mhammaddiranyeng-cell/RiverExtract/figs/photo_crop.jpg

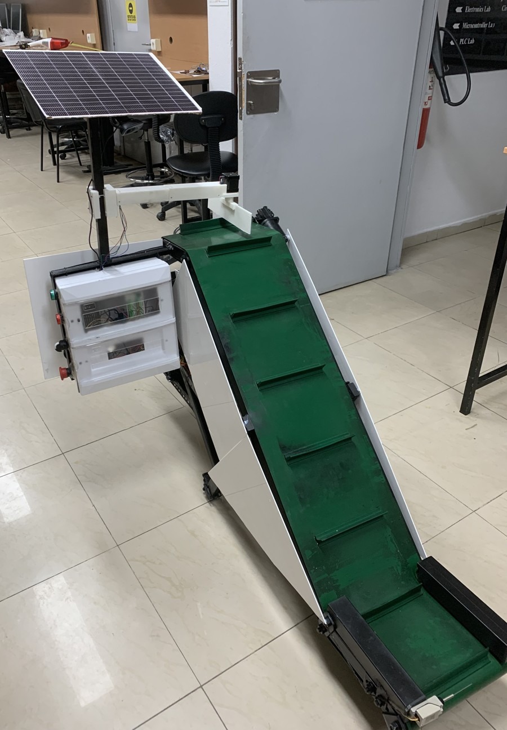
figs/photo_crop.jpg
