mhammaddiranyeng-cell/RiverExtract/figs/fig_geometry.pdf

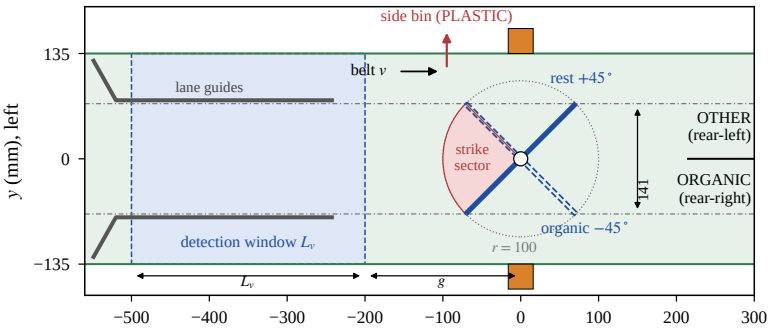
[picture p2: figure]
m), left; belt v lane guides; rest +45 ∘; side bin (PLASTIC)

### x (mm), downstream

| | OTHER (rear-left) strike sector ORGANIC (rear-right)
| detection window Lv | organic −45 ∘ r = 100

### (a) plan view at the design point

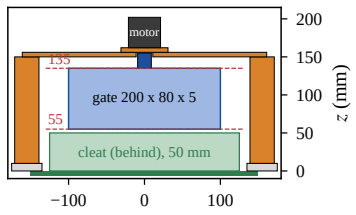
[picture p3: figure]
cleat (behind), 50 mm; motor; gate 200 x 80 x 5

### y (mm)

### (b) section through the pivot
