mhammaddiranyeng-cell/RiverExtract/figs/fig_maps.pdf

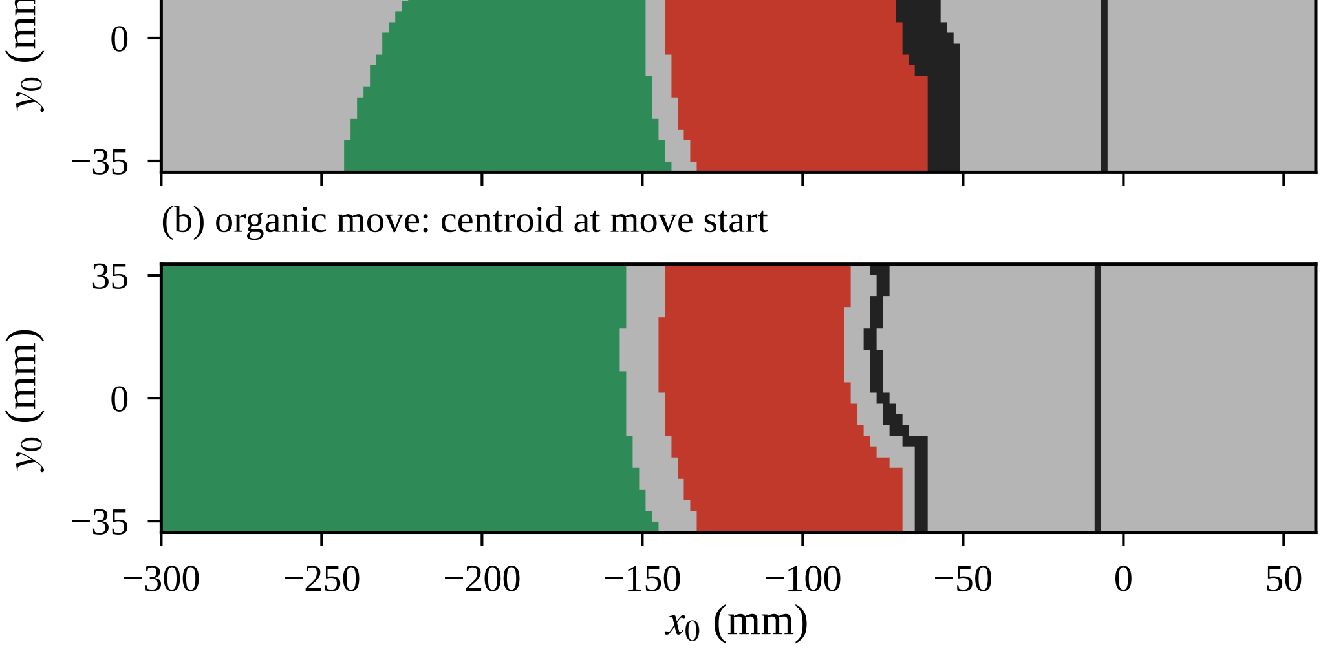
[picture p4: figure]

0

35

m)

(a) plastic strike: centroid at stroke start

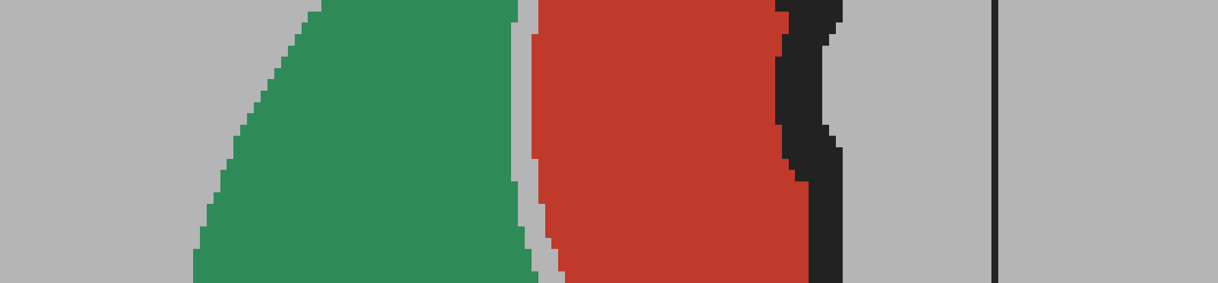
[picture p5: figure]

(b) organic move: centroid at move start

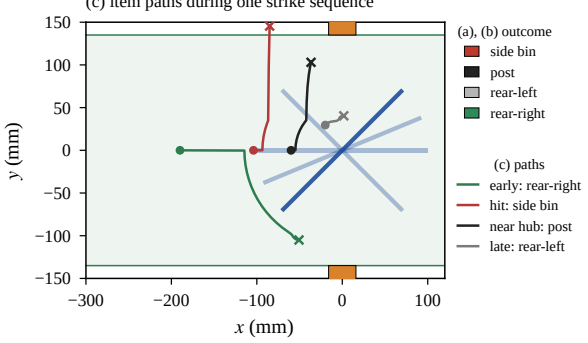
[picture p6: figure]
(c) paths early: rear-right hit: side bin near hub: post late: rear-left; (a), (b) outcome side bin post rear-left rear-right

(c) item paths during one strike sequence
