mhammaddiranyeng-cell/RiverExtract/figs/fig_motion.pdf

0

30

60

90

# Δθ (deg)

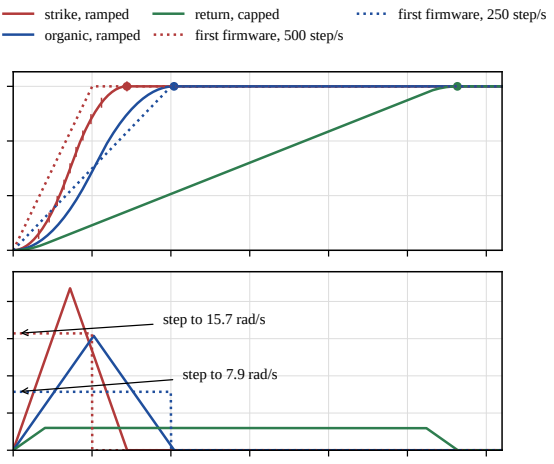
[picture p7: figure]
step to 15.7 rad/s; step to 7.9 rad/s; strike, ramped organic, ramped; return, capped first firmware, 500 step/s; first firmware, 250 step/s

0.0 | 0.1 | 0.2 | 0.3 | 0.4 | 0.5 | 0.6

## time (s)

0

5

10

15

20

## ω (rad/s)
