mhammaddiranyeng-cell/RiverExtract/cad/stl/RiverExtract_v2_SpacerR.stl

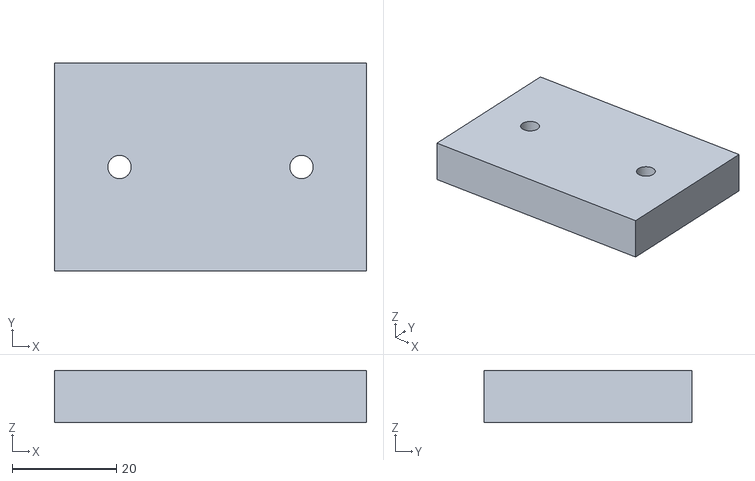
[picture p8: CAD file, 2026-11-01]
cad/stl/RiverExtract_v2_SpacerR.stl
60.0 x 40.0 x 10.0
