mhammaddiranyeng-cell/RiverExtract/cad/stl/RiverExtract_v2_ALL_bed_layout.stl

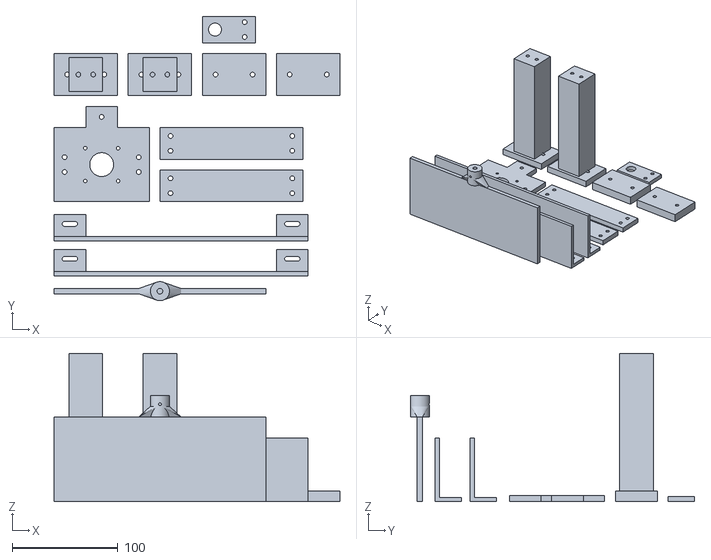
[picture p9: CAD file, 2026-11-01]
cad/stl/RiverExtract_v2_ALL_bed_layout.stl
270.0 x 268.5 x 140.0
