mhammaddiranyeng-cell/RiverExtract/cad/stl/RiverExtract_v2_PostR.stl

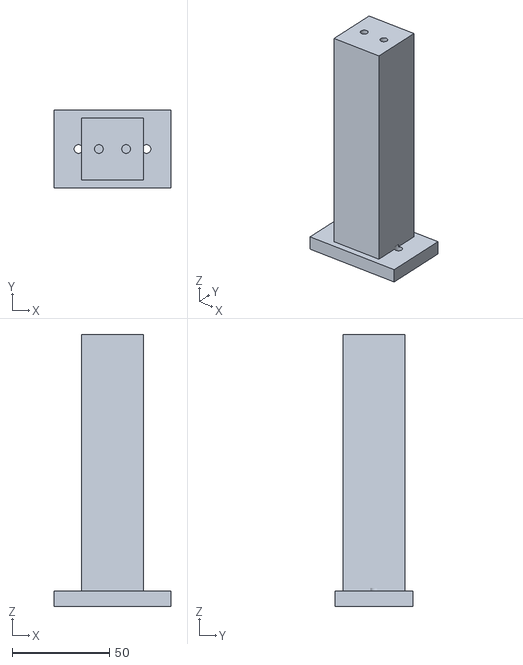
[picture p10: CAD file, 2026-11-01]
cad/stl/RiverExtract_v2_PostR.stl
60.0 x 40.0 x 140.0
