mhammaddiranyeng-cell/RiverExtract/cad/stl/RiverExtract_v2_Gate.stl

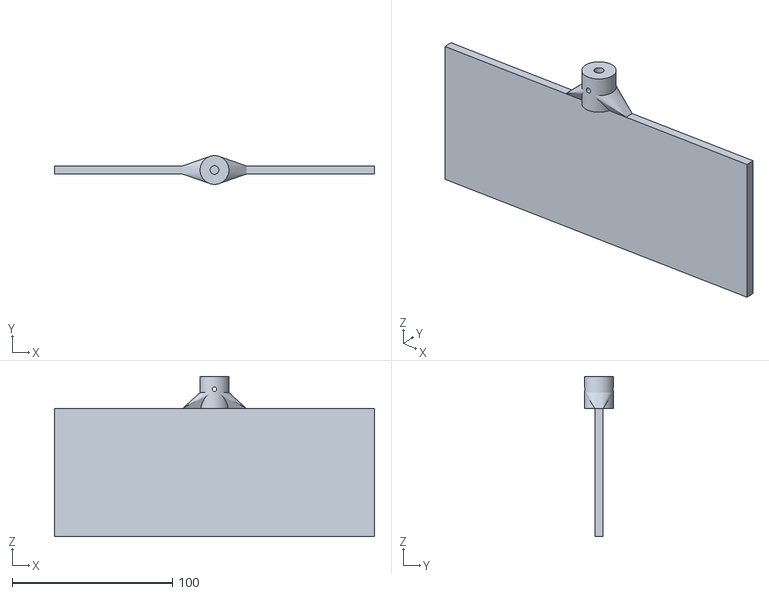
[picture p11: CAD file, 2026-11-01]
cad/stl/RiverExtract_v2_Gate.stl
200.0 x 18.0 x 100.0
