mhammaddiranyeng-cell/RiverExtract/cad/stl/RiverExtract_v2_BeamR.stl

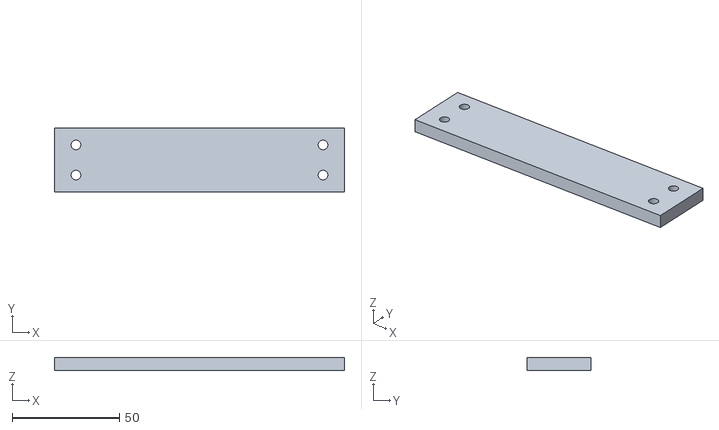
[picture p12: CAD file, 2026-11-01]
cad/stl/RiverExtract_v2_BeamR.stl
135.0 x 30.0 x 6.00
