mhammaddiranyeng-cell/RiverExtract/cad/stl/RiverExtract_v2_GuideR.stl

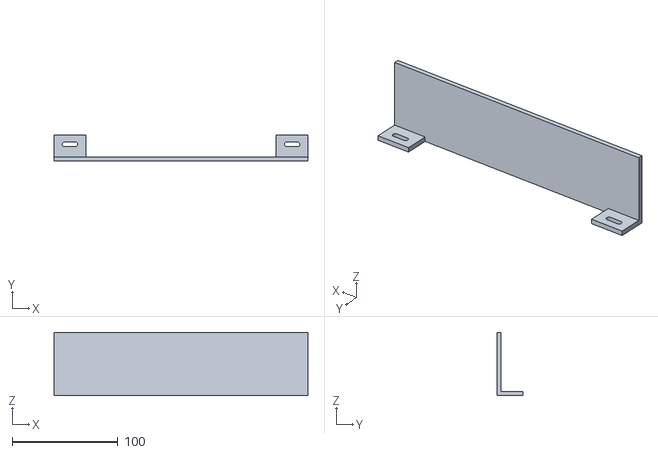
[picture p13: CAD file, 2026-11-01]
cad/stl/RiverExtract_v2_GuideR.stl
240.0 x 25.0 x 60.0
