mhammaddiranyeng-cell/RiverExtract/cad/stl/RiverExtract_v2_Center.stl

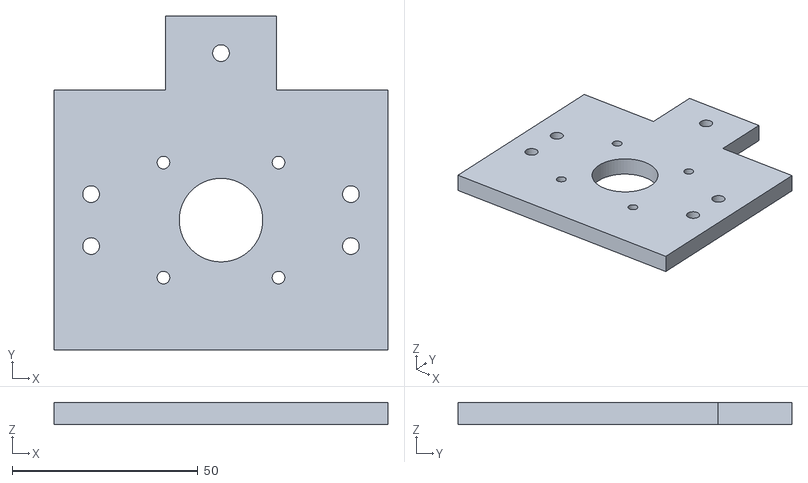
[picture p14: CAD file, 2026-11-01]
cad/stl/RiverExtract_v2_Center.stl
90.0 x 90.0 x 6.00
