mhammaddiranyeng-cell/RiverExtract/cad/stl/RiverExtract_v2_Sensor.stl

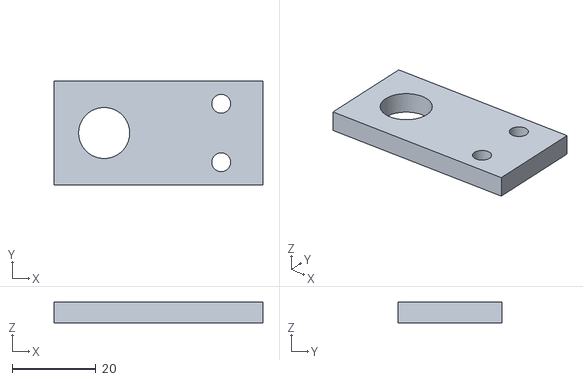
[picture p15: CAD file, 2026-11-01]
cad/stl/RiverExtract_v2_Sensor.stl
50.0 x 25.0 x 5.00
