mhammaddiranyeng-cell/RiverExtract/(list of files, cad)

Other CAD files:
cad/stl/RiverExtract_v2_SpacerL.stl
cad/stl/RiverExtract_v2_GuideL.stl
cad/stl/RiverExtract_v2_BeamL.stl
cad/stl/RiverExtract_v2_PostL.stl
