mhammaddiranyeng-cell/RiverExtract/figs/fig_overview.pdf

(a)

(b)

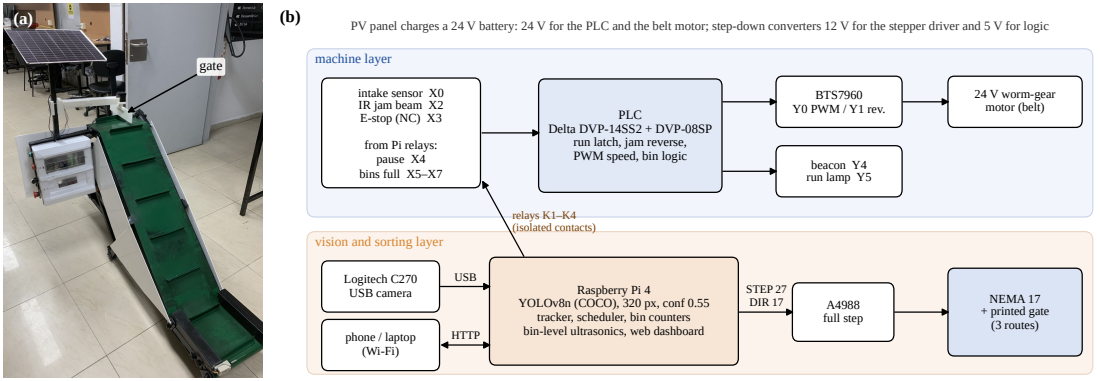
[picture p16: page 1]
gate; machine layer; PLC; BTS7960 Y0 PWM / Y1 rev.; beacon Y4 run lamp Y5; 24 V worm-gear motor (belt); Logitech C270 USB camera; phone / laptop (Wi-Fi); Raspberry Pi 4; A4988 full step; NEMA 17 + printed gate (3 routes); USB; HTTP; STEP 27 DIR 17; relays K1–K4 (isolated contacts)

PV panel charges a 24 V battery: 24 V for the PLC and the belt motor; step-down converters 12 V for the stepper driver and 5 V for logic

intake sensor X0
IR jam beam X2
E-stop (NC) X3

Delta DVP-14SS2 + DVP-08SP
run latch, jam reverse,
PWM speed, bin logic

from Pi relays:
pause X4
bins full X5–X7

vision and sorting layer

YOLOv8n (COCO), 320 px, conf 0.55
tracker, scheduler, bin counters
bin-level ultrasonics, web dashboard
