mhammaddiranyeng-cell/RiverExtract/figs/fig_mc.pdf

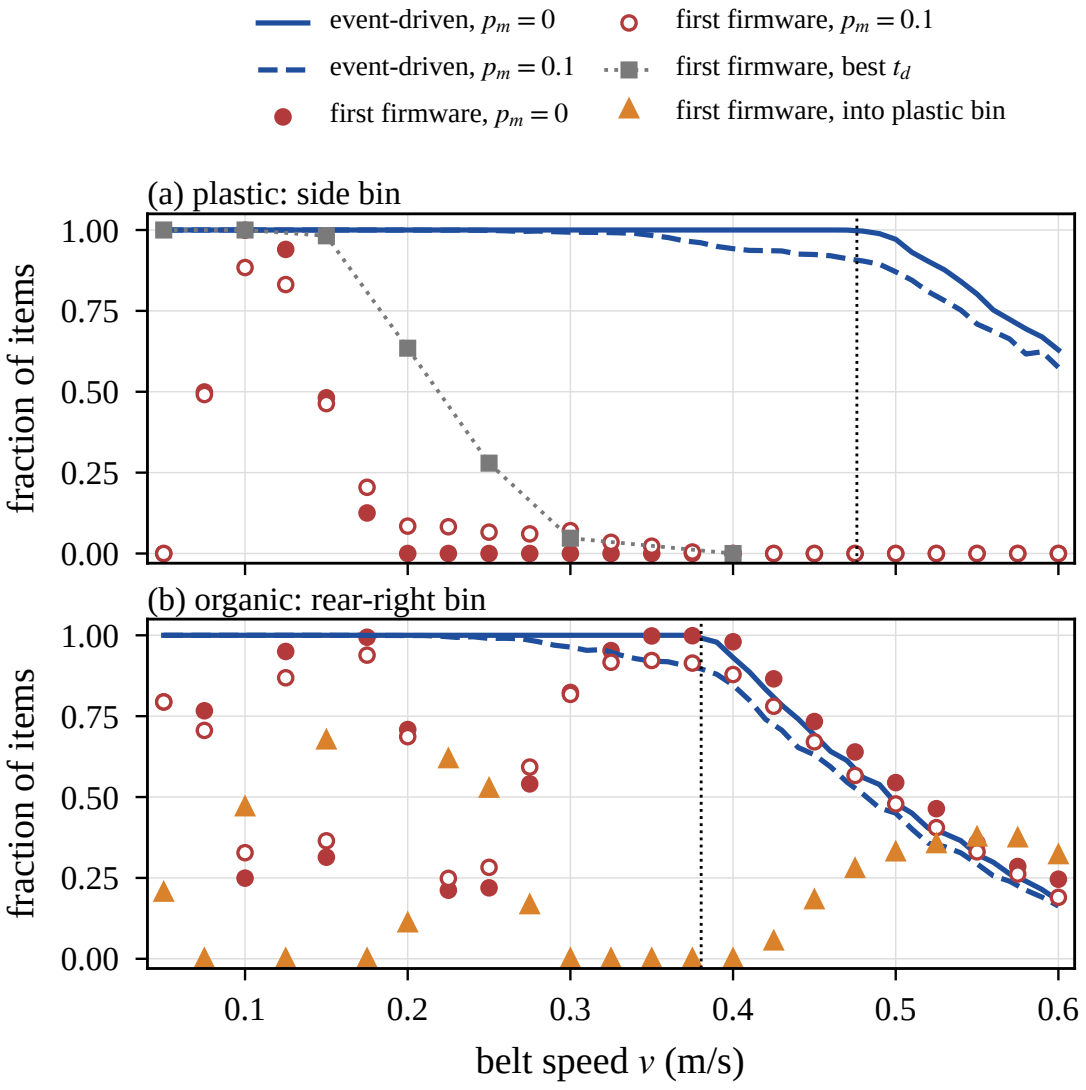
[picture p17: page 1]
belt speed v (m/s); (b) organic: rear-right bin

event-driven, pm = 0
event-driven, pm = 0.1
first firmware, pm = 0

first firmware, pm = 0.1
first firmware, best td
first firmware, into plastic bin

(a) plastic: side bin

fraction of items
