mhammaddiranyeng-cell/RiverExtract/figs/fig_multi.pdf

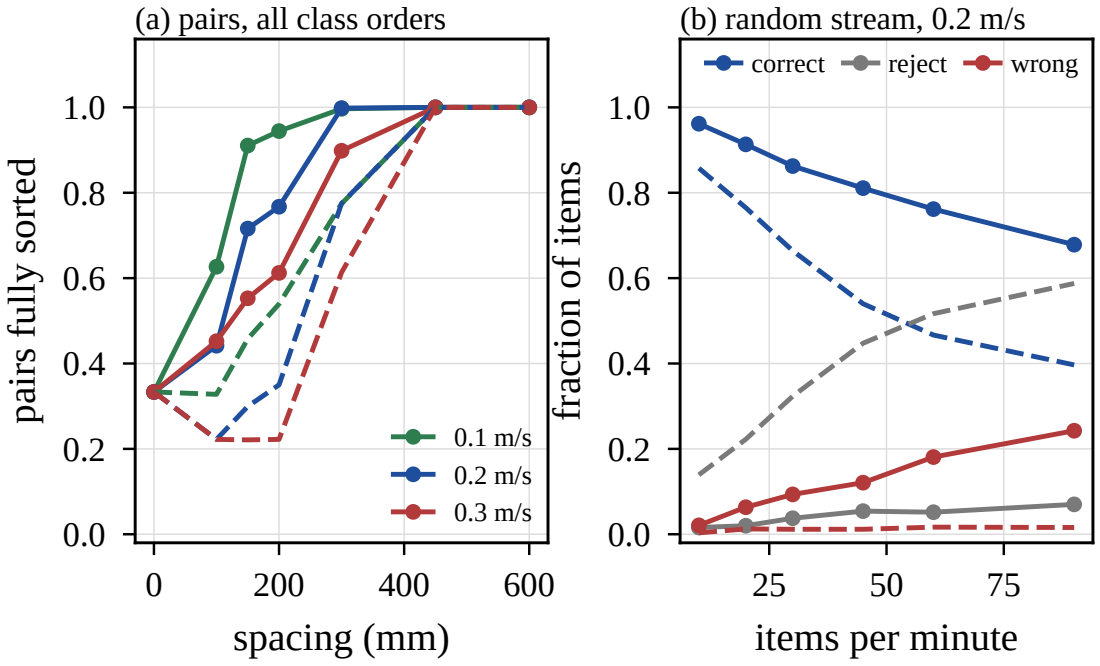
[picture p18: page 1]
spacing (mm); (b) random stream, 0.2 m/s; correct; reject; wrong

(a) pairs, all class orders

pairs fully sorted

fraction of items

0.1 m/s
0.2 m/s 0.3 m/s

items per minute
