mhammaddiranyeng-cell/RiverExtract/(commit log)

2026-11-01 Add simulation, figures, CAD and PLC program for the RiverExtract paper
    - sim/: planar contact model of the printed gate, vision sampling model,
    first-firmware and event-driven controllers, several-item scheduler,
    motor load, and the scripts that write every number and figure
    - figs/, paper/: the figures and numbers as used in the paper
    - matlab/: MATLAB versions of the result figures
    - cad/: OpenSCAD sources and STLs of the gate, bridge and lane guides
    - plc/: Delta DVP-14SS2 program and I/O map
    - firmware/: placeholder until the bench-test firmware is added
    [RiverExtract_Sorter_v2.scad, RiverExtract_v2_ALL_bed_layout.stl, RiverExtract_v2_BeamL.stl, RiverExtract_v2_BeamR.stl, RiverExtract_v2_Center.stl, RiverExtract_v2_Gate.stl, RiverExtract_v2_GuideL.stl, RiverExtract_v2_GuideR.stl]
2026-11-01 Add the sorting firmware and its dashboard
    riverextract_sort_v2.py holds the event-driven controller and the
    calibration block; riverextract_sort_v2_1.py adds logging, the
    first-firmware baseline (--legacy), pacing control and test modes,
    and serves the dashboard. The README covers wiring for the A4988
    and the TB6600, calibration, and the run modes.
2026-11-02 Add stronger baselines and the closed form of the feasibility bound
    - timing.py: replan=False times every action once from the first detection
    (fixed delay); the default reproduces the event-driven controller exactly.
    - run_v3_baseline2.py: fixed delay with encoder or track speed, and the
    event-driven controller with an encoder, at 5 and 10 mm centroid noise.
    - gen_v3.py: baseline speeds, eq. (5) with the timing distance measured from
    the first detection, the linear fit of x*(v) with the closed form of (4),
    and the item-mass limit of the NEMA 23 at 2.2 A. Existing macros unchanged.
